LeonTheGoatRohrer/mechanical-eye/docs/CHECKLIST.md

# Projekt-Checkliste – aktueller innerer Kardan

## Umgesetzt und ausgeführt
- [x] Zwei Hitec-Gehäuse und XT-Gehäuse ortsfest; äußere Ständer und Lidaufnahme ohne Blickbewegung.
- [x] Innere Giergabel und Nickträger mit gemeinsamem nominellen Drehzentrum.
- [x] Strukturelle Schulterachsen, Anlaufscheiben und verschraubte Verbindungen.
- [x] Zwei starre Blickgestänge mit vier räumlichen Kugelgelenken.
- [x] Gekoppelte Nickservo-Berechnung für diagonale Blickrichtungen.
- [x] Weiße, rückseitig offene Kugelschale, getrennte schwarze Pupille; alte Frontwand/Pfosten bleiben entfernt.
- [x] Bestehende gemeinsame XT-Lidkopplung beibehalten; Lidschalen verbreitert und Abstand vergrößert.
- [x] Vorläufige Kameraablage und erhöhte stationäre Kabelklemme.
- [x] 1.581 Blickpositionen analytisch auf Gestängeschließung, Stellweggrenzen und ausgewählte Hüllabstände geprüft.
- [x] Alle vier diagonalen Eckeinstellungen visuell betrachtet; neutraler Zusammenbau abschließend gerendert.
- [x] NOTES und Prüfbericht auf tatsächlichen aktuellen Stand gebracht.
- [x] Separater CAD-Montagezwischenstand für Druckplatten 1 und 2 mit Montagehinweisen; Kaufteile und weiße Schale nicht dargestellt.
- [x] Manuell verstellbare Bewegungsstudie mit ausgewählten CAD-Stellungen; keine automatisch abspielbare Animation.

## Noch offen – keine Fertigungsfreigabe
- [ ] Reale Hitec-/XT-Hornmaße, XT-Einbaumaße, Stellbereich und Leistungsdaten.
- [ ] Filament und Passungstests, insbesondere gedruckte Kugelpfannen und Schulterlager.
- [ ] Kamera, Objektiv, Stecker, Masse, Kabeldurchmesser und Mindestbiegeradius.
- [ ] Vollständige kontinuierliche Solid-Kollisions-/Werkzeug-/Kabelprüfung mit allen Blinkstellungen.
- [ ] Vollständige Last-/Trägheits-/Drehmoment- und Kippsicherheitsauslegung.
- [ ] Schutzanschläge, Neutralmarken und praktische Gestängelängeneinstellung.
- [ ] Vollständige Plattenbelegung mit Supports/Brims im realen P1S-Slicer.
- [ ] Aktuelle Gesamt-BOM, Maßzeichnungen und neue Einzelteil-/Assembly-Exporte.
- [ ] Reale Montage-, Kalibrier-, Bewegungs- und Lebensdauertests.

Lagerangabe 22 mm außen / 9 mm innen bleibt erhalten; Breite/Anzahl offen, Lager aktuell nicht eingesetzt. Alte Phase-A-Dateien sind keine Freigabe des jetzigen Gesamtauges.
