LeonTheGoatRohrer/mechanical-eye/docs/MASSBLATT.md

# Maßblatt – Hitec-Aufnahme / Passungskörper, Stand A

Einheiten mm. Dies ist eine tabellarische Maßdefinition, keine normgerechte technische Zeichnung. Maße beziehen sich auf die ebenen Druckteile, Ursprung jeweils in der XY-Mitte der Unterseite; +Z nach oben. Keine unbestätigten Servo-Hornmaße enthalten.

| Merkmal | Nennmaß/Koordinaten | Status |
|---|---|---|
| Adapter-Außenkontur | 68×34×4 | Entwurf |
| Gehäuseöffnung | 40,8×20,8, mittig | Entwurf, 0,4 je Seite |
| 4 Servo-Befestigungsbohrungen | Ø3,4; x=±23,9; y=±5,1 | Raster aus Herstellerzeichnung |
| 4 Modulbohrungen | Ø3,4; x=±29; y=±12 | Entwurf |
| Grundplatte | 68×34×4; gleiche Modulbohrungen | Entwurf |
| Distanzhülse | Ø8 außen, Ø3,4 innen, Länge24 | Entwurf |
| Gesamte Adapter-Unterseite montiert | z=28 | Aus Grundplatte4 + Hülse24 |
| Auflage der Servo-Laschen | z=32 | Oberseite Adapter |
| Nomineller Servo-Gehäuseboden | z=5,5 | 32−26,5 |
| Freiraum unter Servo zum Sockel | 1,5 | 5,5−4, ohne Kabelausgang |
| Servo-Abtriebsachse | x=+10; y=0 zum Modulzentrum | Herstellerzeichnung |

Hersteller-Flanschöffnungen Ø4,5 sind offene Ausschnitte; die gedruckten Ø3,4-Durchgänge sind für einen vorgeschlagenen M3-Schraubsatz ausgelegt. Gummitüllen/Messinghülsen sind NICHT angenommen. Falls vorhanden, Einbauhöhe und Schraubensatz anpassen. Unterlegscheiben sollen die Laschen sicher überdecken; Schrauben nicht gegen Kunststoff zerquetschen. Werkzeug-/Kabelprüfung am Original bleibt nötig.

## Lager- und Gelenk-Testkörper
`fitCoupon.kcl`,100×48×4:
- Große Durchgänge: Mitten(-32,4),(0,4),(32,4); Ø22,1/22,2/22,3.
- Kleine Durchgänge: Mitten(-32,-17),(0,-17),(32,-17); Ø4,1/4,2/4,3.
- Zum Ablesen kleine Lochreihe nach vorn/unten legen; Spiel nimmt von links nach rechts zu.
`fitPin.kcl`: Ø8,8-Schaft, Fuß Ø14×2; Gesamthöhe bei provisorischer Lagerbreite7 =12,5. Der Zapfen ist ein Messversuch, keine tragende Endkonstruktion.

Eine Lageraufnahme mit Breitenanschlag und verschraubtem Haltering wurde noch nicht konstruiert. Deshalb liegt dafür keine fertige Maßzeichnung vor.
