LeonTheGoatRohrer/mechanical-eye/exports/assembly/main.stl

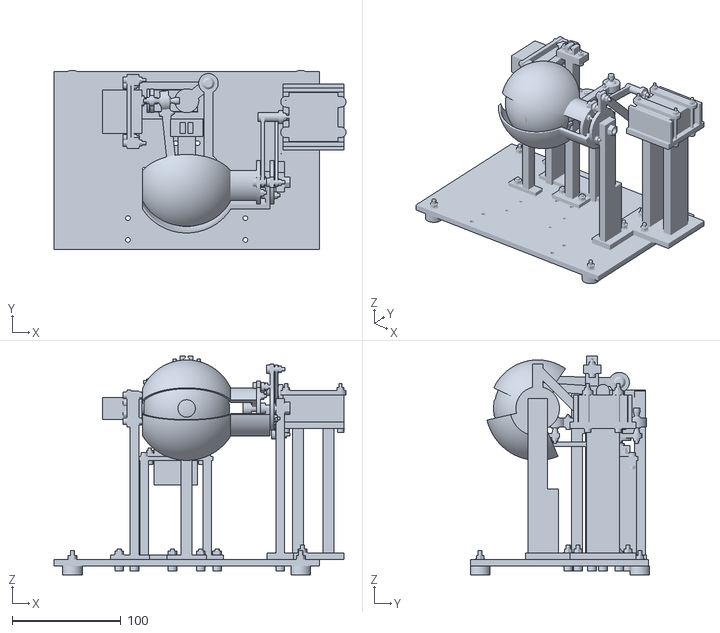
[picture p5: CAD file, 2026-11-02]
exports/assembly/main.stl
268.5 x 165.0 x 201.0
