LeonTheGoatRohrer/mechanical-eye/Auge1.stl

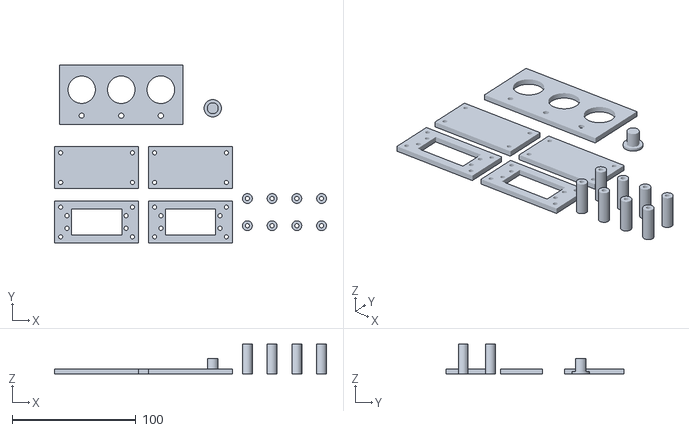
[picture p6: CAD file, 2026-10-29]
Auge1.stl
220.0 x 144.0 x 24.0
