LeonTheGoatRohrer/mechanical-eye/exports/print-plates/printPlate01Black.stl

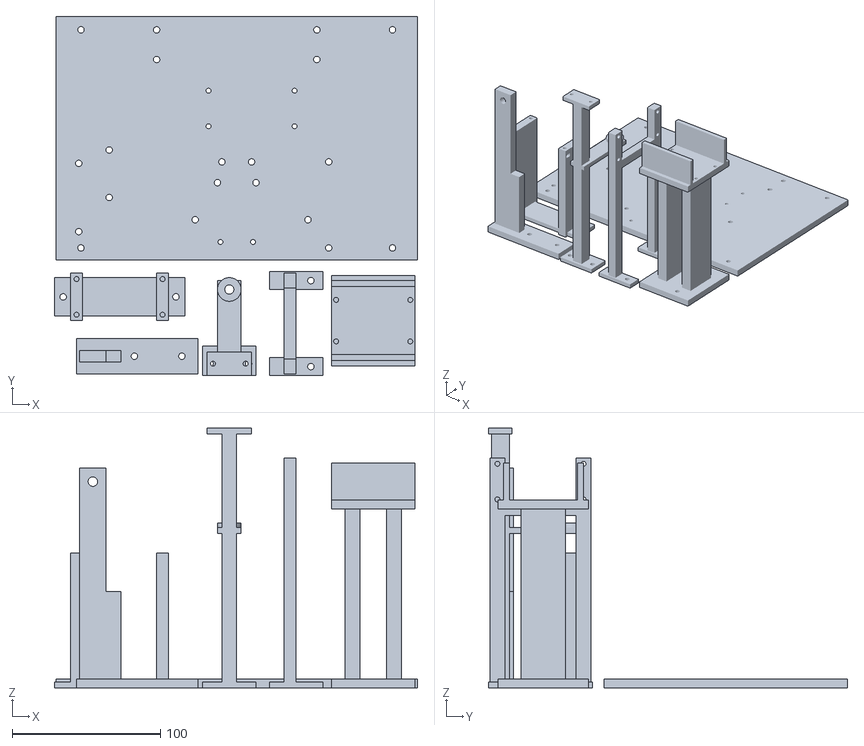
[picture p7: CAD file, 2026-11-02]
exports/print-plates/printPlate01Black.stl
245.0 x 242.0 x 175.0
