LeonTheGoatRohrer/mechanical-eye/exports/print-plates/printPlate02Black.stl

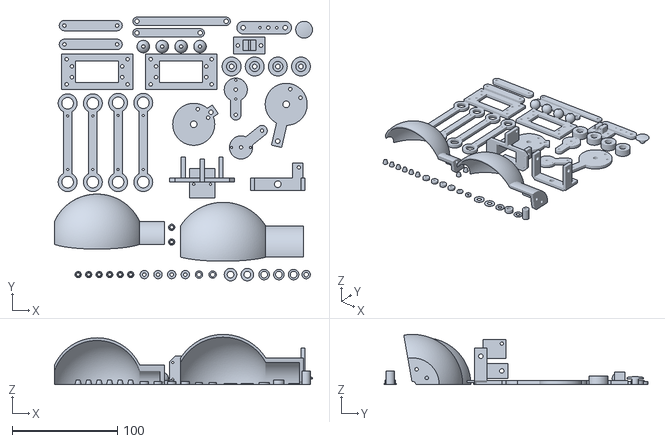
[picture p8: CAD file, 2026-11-02]
exports/print-plates/printPlate02Black.stl
245.5 x 251.0 x 47.8
