LeonTheGoatRohrer/mechanical-eye/exports/print-plates/printPlate03White.stl

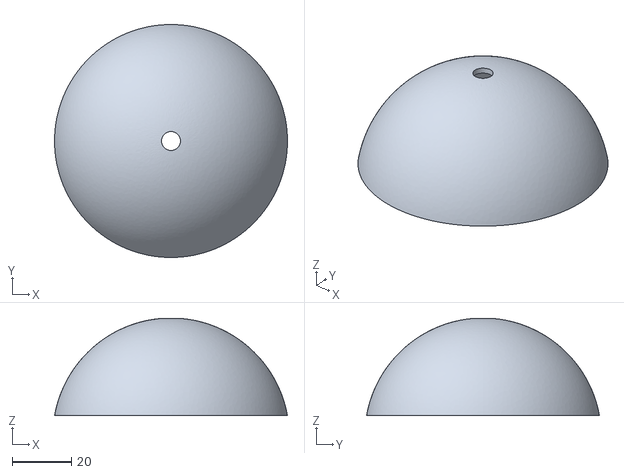
[picture p9: CAD file, 2026-11-02]
exports/print-plates/printPlate03White.stl
78.8 x 78.8 x 32.9
