LeonTheGoatRohrer/mechanical-eye/(list of files, cad)

Other CAD files:
exports/assembly/RoboEye.obj
