LeonTheGoatRohrer/mechanical-eye/(commit log)

2026-10-29 chore: prepare documented and reviewed portfolio source
    [Auge1.stl]
2026-11-02 Add complete RoboEye assembly, three print plates and CAD sources
    [BOM.csv, DRUCKTEILE.csv, RoboEye.obj, main.stl, printPlate01Black.stl, printPlate02Black.stl, printPlate03White.stl]
